ericwu17/SPI_steno_keyboard_kicad/s.kicad_pcb

## KiCad design s.kicad_pcb (2025-11-19)

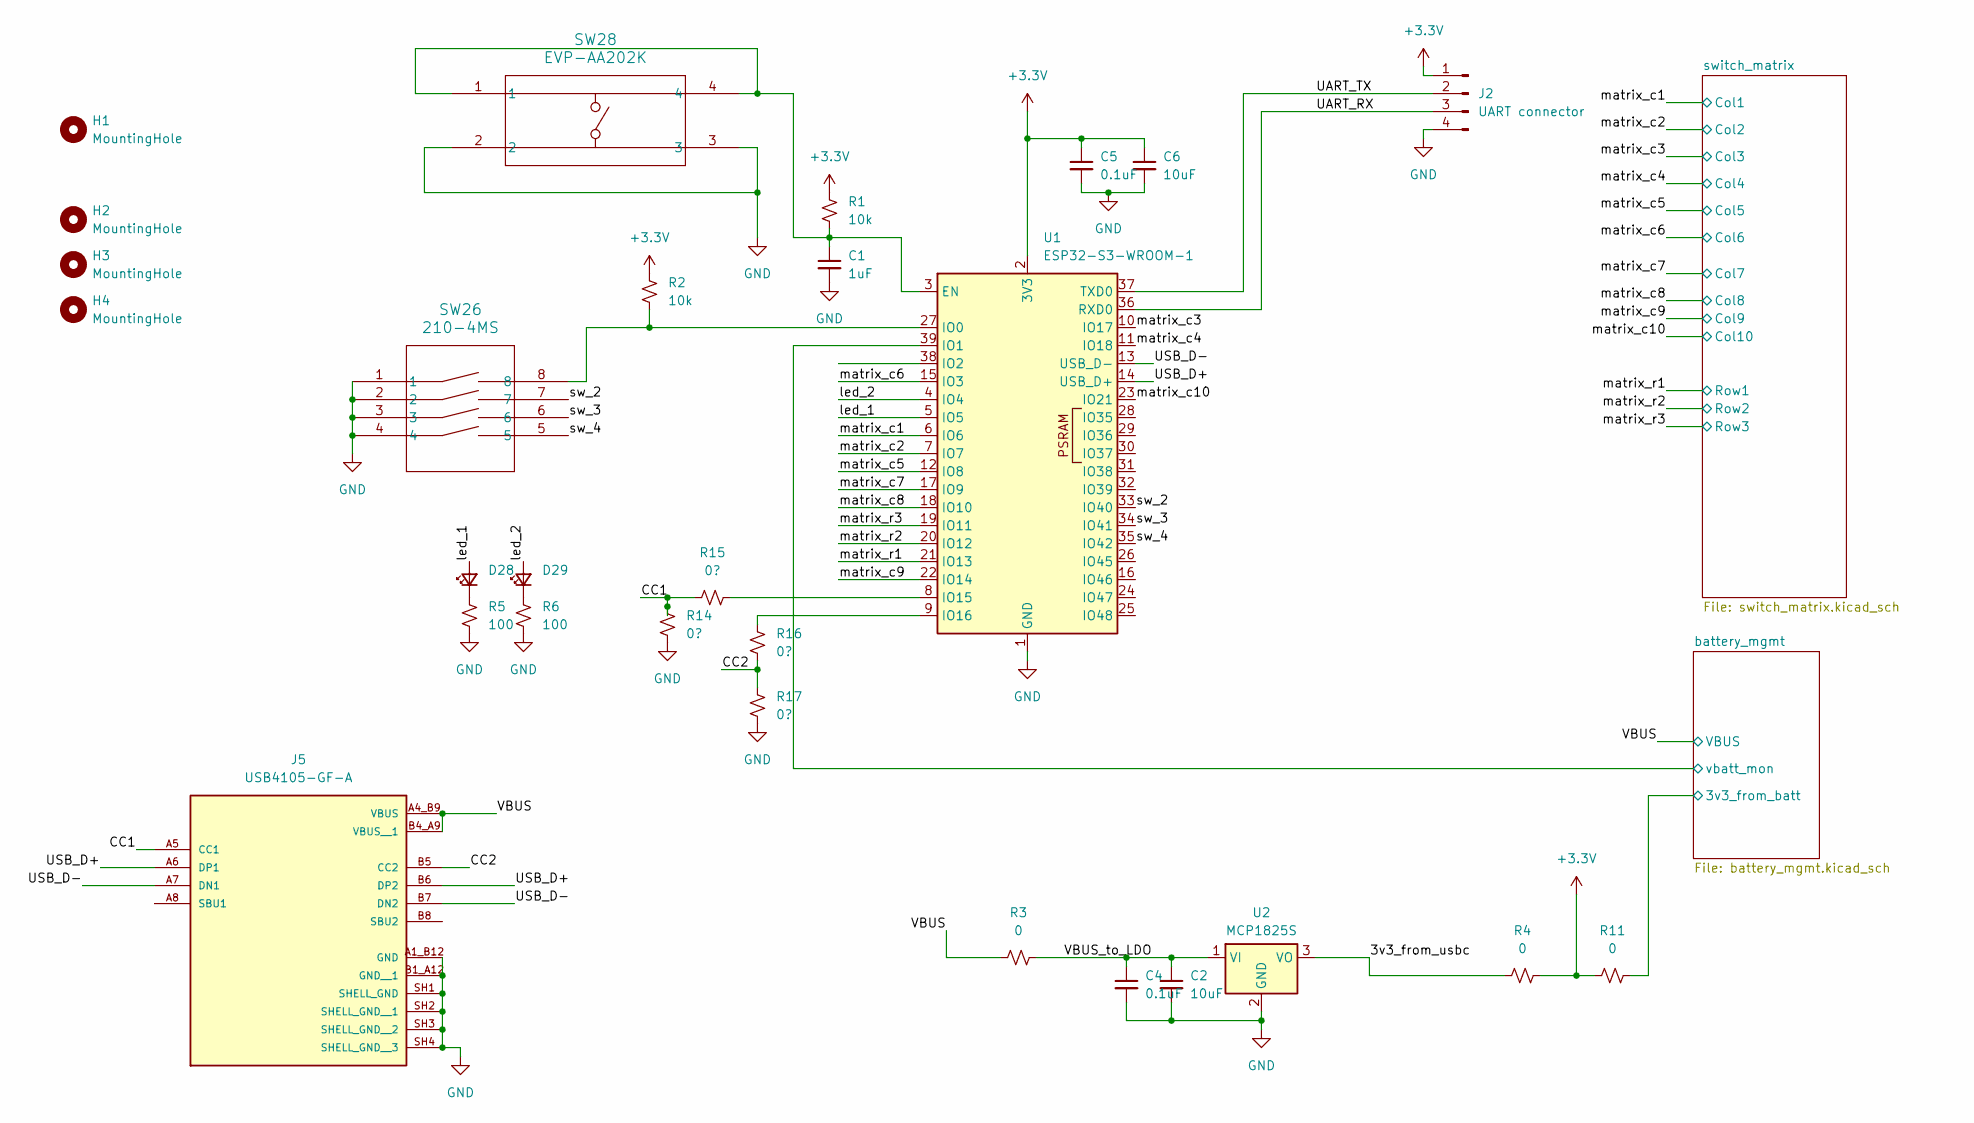
[picture p1: schematic s.kicad_sch]

Parts:
C1: 1uF; C_0805_2012Metric_Pad1.18x1.45mm_HandSolder
C2, C6: 10uF; C_0805_2012Metric_Pad1.18x1.45mm_HandSolder
C4, C5: 0.1uF; C_0805_2012Metric_Pad1.18x1.45mm_HandSolder
D28, D29: LED_0805_2012Metric_Pad1.15x1.40mm_HandSolder
H1, H2, H3, H4: MountingHole; MountingHole_3mm
J2: UART connector; PinHeader_1x04_P2.54mm_Vertical
J5: USB4105-GF-A; GCT_USB4105-GF-A; PARTREV B4
R1, R2: 10k; R_0805_2012Metric_Pad1.20x1.40mm_HandSolder
R3, R4, R11: 0; R_0805_2012Metric_Pad1.20x1.40mm_HandSolder
R5, R6: 100; R_0805_2012Metric_Pad1.20x1.40mm_HandSolder
R14, R15, R16, R17: 0?; R_0805_2012Metric_Pad1.20x1.40mm_HandSolder
SW26: 210-4MS; DIP8_210-4_CTS
SW28: EVP-AA202K; SW_EVP-AA102K_PAN
U1: ESP32-S3-WROOM-1
U2: MCP1825S; SOT-223-3_TabPin2

Connections:
+3.3V: C5.1, C6.1, J2.1, R1.1, R2.1, R4.2, R11.1, U1.2 (3V3)
/3v3_from_usbc: R4.1, U2.3 (VO)
/CC1: J5.A5 (CC1), R14.1, R15.1
/CC2: J5.B5 (CC2), R16.1, R17.1
/UART_RX: J2.3, U1.36 (RXD0)
/UART_TX: J2.2, U1.37 (TXD0)
/USB_D+: J5.A6 (DP1), J5.B6 (DP2), U1.14 (USB_D+)
/USB_D-: J5.A7 (DN1), J5.B7 (DN2), U1.13 (USB_D-)
/VBUS: J5.A4_B9 (VBUS), J5.B4_A9 (VBUS__1), R3.1; also elsewhere on the board
/VBUS_to_LDO: C2.1, C4.1, R3.2, U2.1 (VI)
/battery_mgmt/3v3_from_batt: R11.2; also elsewhere on the board
/battery_mgmt/vbatt_mon: U1.39 (IO1); also elsewhere on the board
/led_1: D28.2 (A), U1.5 (IO5)
/led_2: D29.2 (A), U1.4 (IO4)
/matrix_c1: U1.6 (IO6); also elsewhere on the board
/matrix_c2: U1.7 (IO7); also elsewhere on the board
/matrix_c3: U1.10 (IO17); also elsewhere on the board
/matrix_c4: U1.11 (IO18); also elsewhere on the board
/matrix_c5: U1.12 (IO8); also elsewhere on the board
/matrix_c6: U1.15 (IO3); also elsewhere on the board
/matrix_c7: U1.17 (IO9); also elsewhere on the board
/matrix_c8: U1.18 (IO10); also elsewhere on the board
/matrix_c9: U1.22 (IO14); also elsewhere on the board
/matrix_c10: U1.23 (IO21); also elsewhere on the board
/matrix_r1: U1.21 (IO13); also elsewhere on the board
/matrix_r2: U1.20 (IO12); also elsewhere on the board
/matrix_r3: U1.19 (IO11); also elsewhere on the board
/sw_2: SW26.7, U1.33 (IO40)
/sw_3: SW26.6, U1.34 (IO41)
/sw_4: SW26.5, U1.35 (IO42)
GND: C1.2, C2.2, C4.2, C5.2, C6.2, J2.4, J5.A1_B12 (GND), J5.B1_A12 (GND__1), J5.SH1 (SHELL_GND), J5.SH2 (SHELL_GND__1), J5.SH3 (SHELL_GND__2), J5.SH4 (SHELL_GND__3), R5.2, R6.2, R14.2, R17.2, SW26.1, SW26.2, SW26.3, SW26.4, SW28.2, SW28.3, U1.1 (GND), U1.40 (GND), U1.41 (GND), U2.2 (GND); also elsewhere on the board
unnamed: D28.1 (K), R5.1
unnamed: D29.1 (K), R6.1
unnamed: C1.1, R1.2, SW28.1, SW28.4, U1.3 (EN)
unnamed: R2.2, SW26.8, U1.27 (IO0)
unnamed: R15.2, U1.8 (IO15)
unnamed: R16.2, U1.9 (IO16)

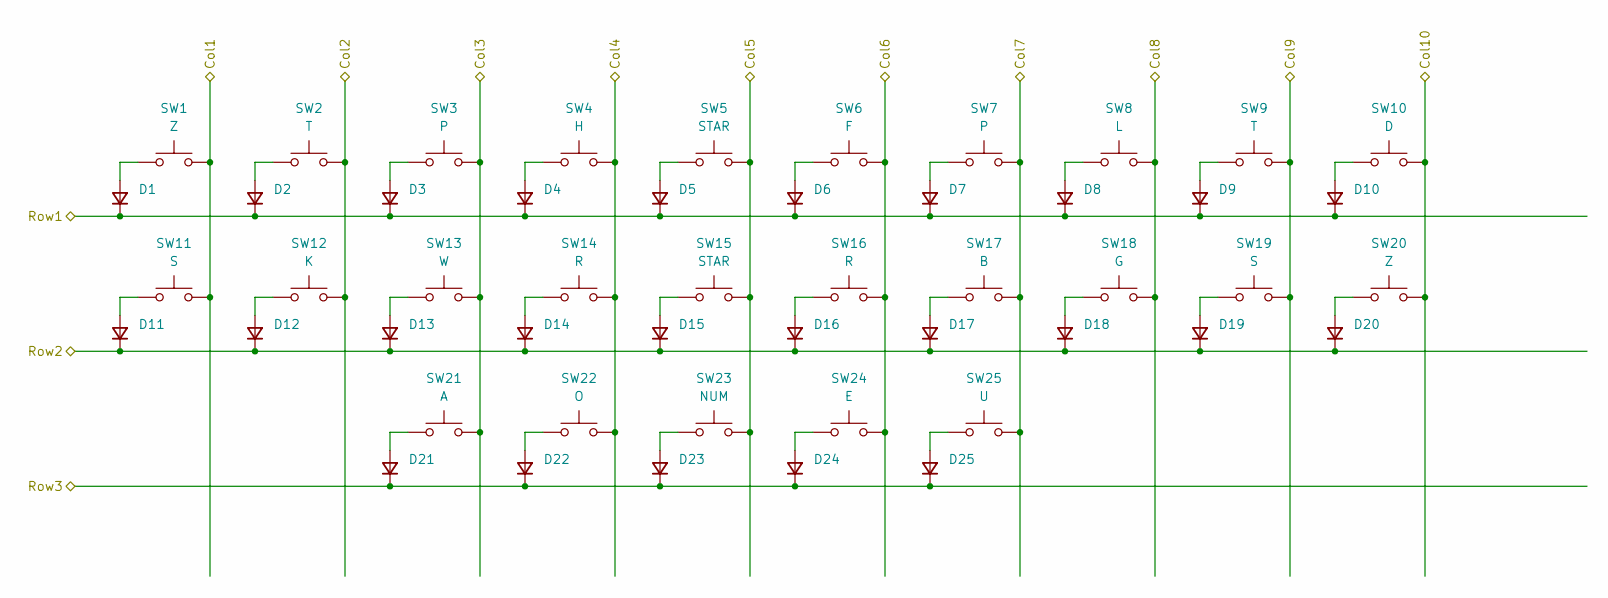
[picture p2: schematic switch_matrix.kicad_sch]

Parts:
D1, D2, D3, D4, D5, D6, D7, D8, D9, D10, D11, D12, D13, D14, D15, D16, D17, D18, D19, D20, D21, D22, D23, D24, D25: D_SOD-323_HandSoldering
SW1, SW20: Z; SW_Kailh_Choc_V1_THT
SW2, SW9: T; SW_Kailh_Choc_V1_THT
SW3, SW7: P; SW_Kailh_Choc_V1_THT
SW4: H; SW_Kailh_Choc_V1_THT
SW5, SW15: STAR; SW_Kailh_Choc_V1_THT
SW6: F; SW_Kailh_Choc_V1_THT
SW8: L; SW_Kailh_Choc_V1_THT
SW10: D; SW_Kailh_Choc_V1_THT
SW11, SW19: S; SW_Kailh_Choc_V1_THT
SW12: K; SW_Kailh_Choc_V1_THT
SW13: W; SW_Kailh_Choc_V1_THT
SW14, SW16: R; SW_Kailh_Choc_V1_THT
SW17: B; SW_Kailh_Choc_V1_THT
SW18: G; SW_Kailh_Choc_V1_THT
SW21: A; SW_Kailh_Choc_V1_THT
SW22: O; SW_Kailh_Choc_V1_THT
SW23: NUM; SW_Kailh_Choc_V1_THT
SW24: E; SW_Kailh_Choc_V1_THT
SW25: U; SW_Kailh_Choc_V1_THT

Connections:
/matrix_c1: SW1.2, SW11.2; also elsewhere on the board
/matrix_c2: SW2.2, SW12.2; also elsewhere on the board
/matrix_c3: SW3.2, SW13.2, SW21.2; also elsewhere on the board
/matrix_c4: SW4.2, SW14.2, SW22.2; also elsewhere on the board
/matrix_c5: SW5.2, SW15.2, SW23.2; also elsewhere on the board
/matrix_c6: SW6.2, SW16.2, SW24.2; also elsewhere on the board
/matrix_c7: SW7.2, SW17.2, SW25.2; also elsewhere on the board
/matrix_c8: SW8.2, SW18.2; also elsewhere on the board
/matrix_c9: SW9.2, SW19.2; also elsewhere on the board
/matrix_c10: SW10.2, SW20.2; also elsewhere on the board
/matrix_r1: D1.1 (K), D2.1 (K), D3.1 (K), D4.1 (K), D5.1 (K), D6.1 (K), D7.1 (K), D8.1 (K), D9.1 (K), D10.1 (K); also elsewhere on the board
/matrix_r2: D11.1 (K), D12.1 (K), D13.1 (K), D14.1 (K), D15.1 (K), D16.1 (K), D17.1 (K), D18.1 (K), D19.1 (K), D20.1 (K); also elsewhere on the board
/matrix_r3: D21.1 (K), D22.1 (K), D23.1 (K), D24.1 (K), D25.1 (K); also elsewhere on the board
unnamed: D1.2 (A), SW1.1
unnamed: D2.2 (A), SW2.1
unnamed: D3.2 (A), SW3.1
unnamed: D4.2 (A), SW4.1
unnamed: D5.2 (A), SW5.1
unnamed: D6.2 (A), SW6.1
unnamed: D7.2 (A), SW7.1
unnamed: D8.2 (A), SW8.1
unnamed: D9.2 (A), SW9.1
unnamed: D10.2 (A), SW10.1
unnamed: D11.2 (A), SW11.1
unnamed: D12.2 (A), SW12.1
unnamed: D13.2 (A), SW13.1
unnamed: D14.2 (A), SW14.1
unnamed: D15.2 (A), SW15.1
unnamed: D16.2 (A), SW16.1
unnamed: D17.2 (A), SW17.1
unnamed: D18.2 (A), SW18.1
unnamed: D19.2 (A), SW19.1
unnamed: D20.2 (A), SW20.1
unnamed: D21.2 (A), SW21.1
unnamed: D22.2 (A), SW22.1
unnamed: D23.2 (A), SW23.1
unnamed: D24.2 (A), SW24.1
unnamed: D25.2 (A), SW25.1

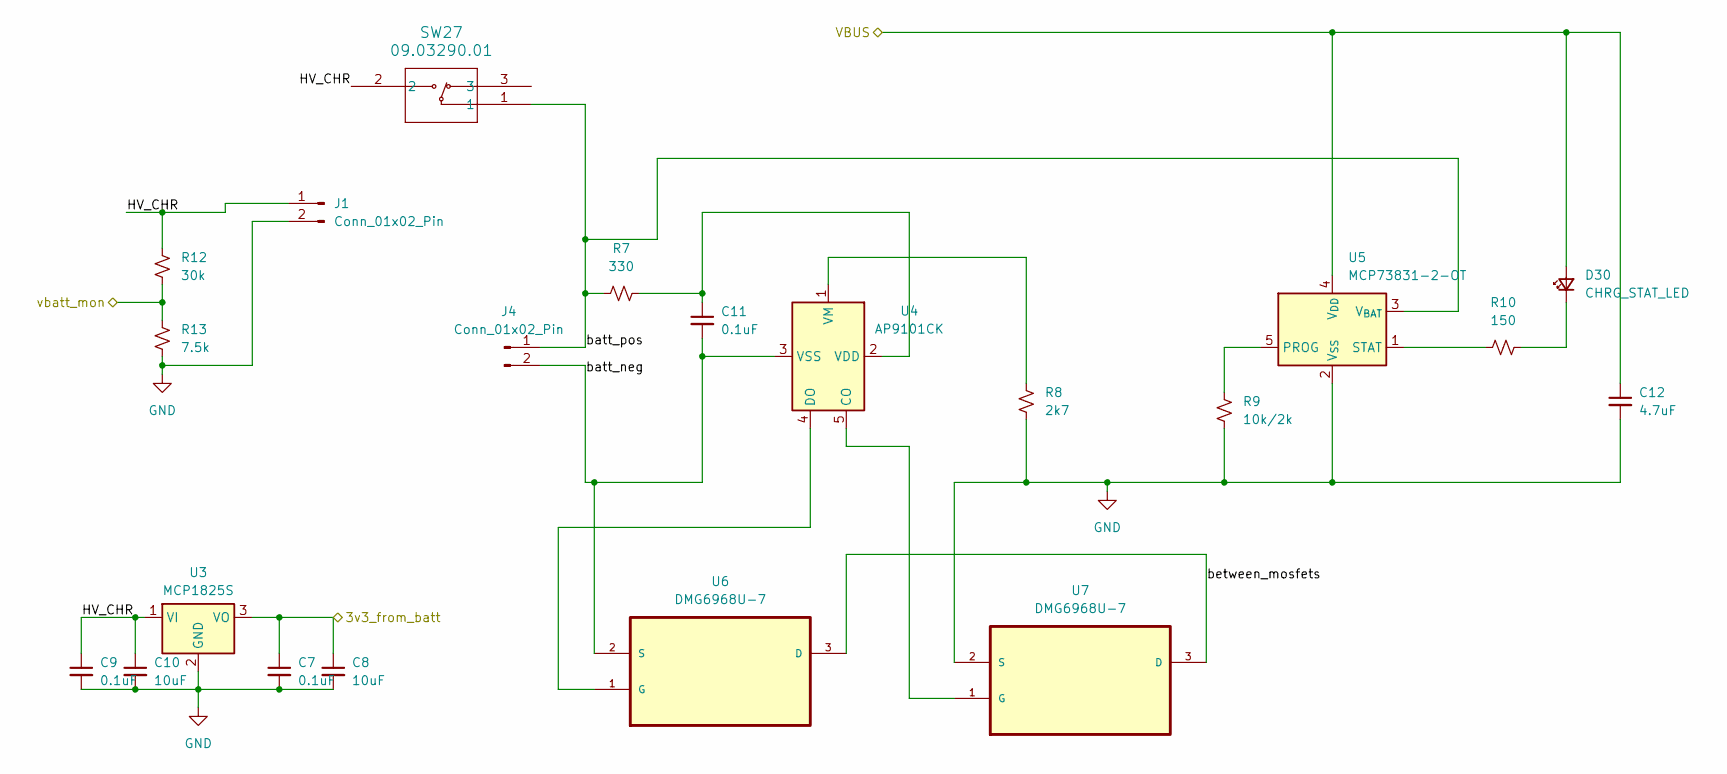
[picture p3: schematic battery_mgmt.kicad_sch]

Parts:
C7, C9, C11: 0.1uF; C_0805_2012Metric_Pad1.18x1.45mm_HandSolder
C8, C10: 10uF; C_0805_2012Metric_Pad1.18x1.45mm_HandSolder
C12: 4.7uF; C_0805_2012Metric_Pad1.18x1.45mm_HandSolder
D30: CHRG_STAT_LED; LED_0805_2012Metric_Pad1.15x1.40mm_HandSolder
J1: Conn_01x02_Pin; PinHeader_1x02_P2.54mm_Vertical
J4: Conn_01x02_Pin; JST_PH_S2B-PH-K_1x02_P2.00mm_Horizontal
R7: 330; R_0805_2012Metric_Pad1.20x1.40mm_HandSolder
R8: 2k7; R_0805_2012Metric_Pad1.20x1.40mm_HandSolder
R9: 10k/2k; R_0805_2012Metric_Pad1.20x1.40mm_HandSolder
R10: 150; R_0805_2012Metric_Pad1.20x1.40mm_HandSolder
R12: 30k; R_0805_2012Metric_Pad1.20x1.40mm_HandSolder
R13: 7.5k; R_0805_2012Metric_Pad1.20x1.40mm_HandSolder
SW27: 09.03290.01; 09.03290_EAO
U3: MCP1825S; SOT-223-3_TabPin2
U4: AP9101CK; SOT-23-5
U5: MCP73831-2-OT; SOT-23-5
U6, U7: DMG6968U-7; SOT95P240X110-3N; MPN DMG6968U-7

Connections:
/VBUS: C12.1, D30.2 (A), U5.4 (V_{DD}); also elsewhere on the board
/battery_mgmt/3v3_from_batt: C7.1, C8.1, U3.3 (VO); also elsewhere on the board
/battery_mgmt/HV_CHR: C9.1, C10.1, J1.1, R12.1, SW27.2, U3.1 (VI)
/battery_mgmt/batt_neg: C11.2, J4.2, U4.3 (VSS), U6.2 (S)
/battery_mgmt/batt_pos: J4.1, R7.1, SW27.1, U5.3 (V_{BAT})
/battery_mgmt/between_mosfets: U6.3 (D), U7.3 (D)
/battery_mgmt/vbatt_mon: R12.2, R13.1; also elsewhere on the board
GND: C7.2, C8.2, C9.2, C10.2, C12.2, J1.2, R8.2, R9.2, R13.2, U3.2 (GND), U5.2 (V_{SS}), U7.2 (S); also elsewhere on the board
unnamed: D30.1 (K), R10.2
unnamed: U4.5 (CO), U7.1 (G)
unnamed: U4.4 (DO), U6.1 (G)
unnamed: C11.1, R7.2, U4.2 (VDD)
unnamed: R8.1, U4.1 (VM)
unnamed: R9.1, U5.5 (PROG)
unnamed: R10.1, U5.1 (STAT)

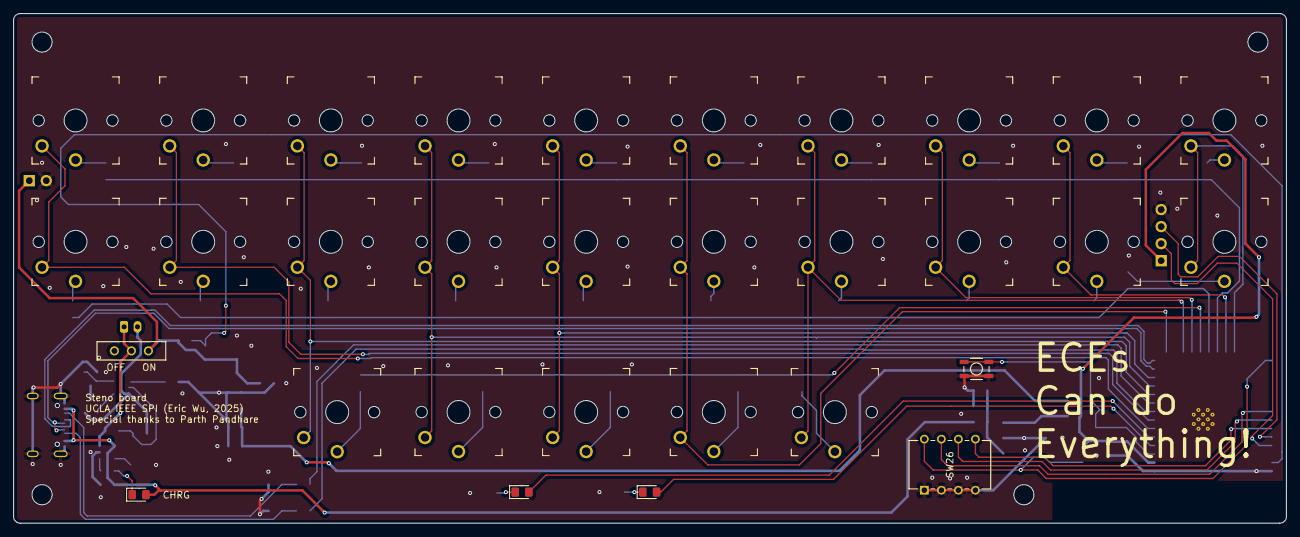
[picture p4: board s.kicad_pcb from above]

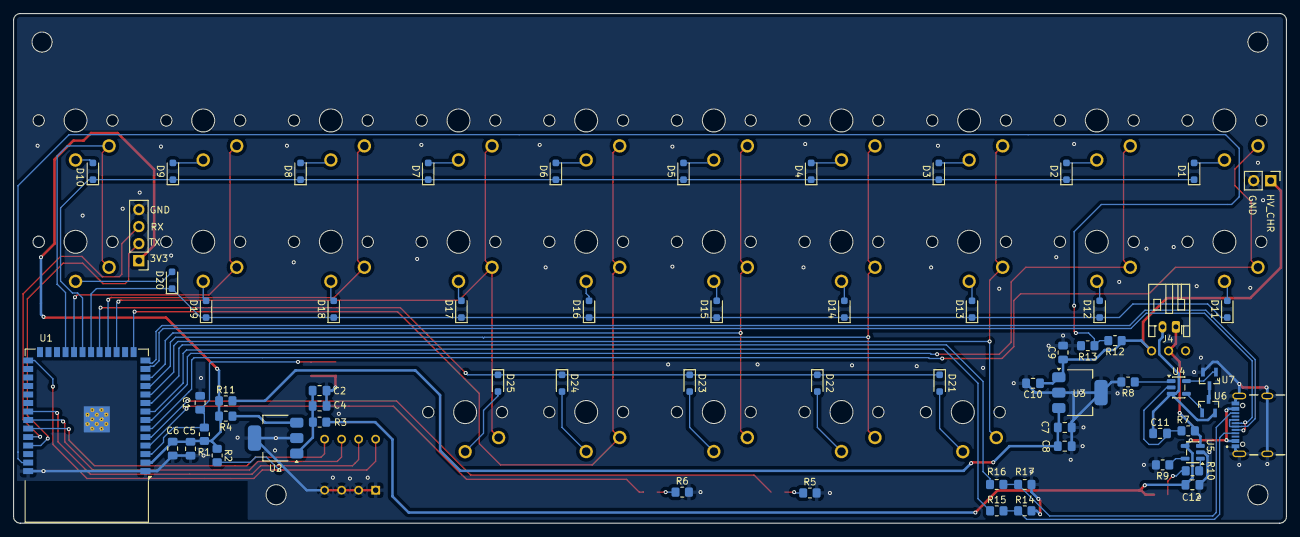
[picture p5: board s.kicad_pcb from below]

Board: 2 copper layers, 190.0 x 76.0 mm, 99 parts (64 on the bottom side), 73 nets.
