ericwu17/SPI_steno_keyboard_kicad/(commit log)

2025-10-25 initial commit 2: initialize project
    [s.kicad_pcb, s.kicad_sch]
2025-10-25 got basic MCU powering from USBC
    [s.kicad_pcb, s.kicad_sch, switch_matrix.kicad_sch]
2025-10-25 make key matrix
    [s.kicad_sch, switch_matrix.kicad_sch]
2025-10-25 rename backup, for somme reason
    idk why kicad did this
2025-10-25 connect MCU to matrix
    [s.kicad_sch, switch_matrix.kicad_sch]
2025-10-26 add supporting stuff and assigned footprints
    [s.kicad_pcb, s.kicad_sch, switch_matrix.kicad_sch]
2025-10-26 copied battery charging schematic
    [battery_mgmt.kicad_sch, s.kicad_sch]
2025-10-26 update footprints
    [battery_mgmt.kicad_sch, s.kicad_pcb]
2025-10-26 move stuff around on pcb
    [s.kicad_pcb]
2025-10-26 routed the key matrix
    [s.kicad_pcb, s.kicad_sch]
2025-10-26 quick commit: moved stuff around and deleted a capacitor
    [s.kicad_pcb, s.kicad_sch]
2025-10-26 route some more stuff
    [s.kicad_pcb, s.kicad_sch]
2025-10-26 route dip switches
    [s.kicad_pcb]
2025-10-26 route battery charging stuff
    [battery_mgmt.kicad_sch, s.kicad_pcb]
2025-10-26 move stuff around (minor)
    [s.kicad_pcb]
2025-10-27 add submodule for Kailh Choc V1 footprints
2025-10-27 change key footprints to kailh choc (PCB not fixed yet)
    [s.kicad_pcb, switch_matrix.kicad_sch]
2025-10-27 remove 2 of the 4 user LEDs
    [s.kicad_pcb, s.kicad_sch]
2025-10-27 PCB cleanup remove old row/col traces
    [s.kicad_pcb]
2025-10-28 route PCB with new keys and new key spacing
    key spacing done by hand
    [s.kicad_pcb]
2025-10-30 modify schematic: add switch between voltage regs
    [battery_mgmt.kicad_sch, s.kicad_sch]
2025-10-30 work on PCB
    [s.kicad_pcb]
2025-10-30 more work on PCB: routed grounds
    [s.kicad_pcb, s.kicad_sch]
2025-10-30 fix DRC violations and warnings
    [s.kicad_pcb]
2025-11-01 use 0-ohm resistors, not switches, to control power source
    [s.kicad_pcb, s.kicad_sch]
2025-11-01 add a voltage divider for battery voltage monitoring
    [battery_mgmt.kicad_sch, s.kicad_pcb, s.kicad_sch]
2025-11-06 make gap in PCB for antenna
    [s.kicad_pcb]
2025-11-06 remove silkscreen from MCU component
    [s.kicad_pcb]
2025-11-06 change min hole size to 0.2 mm
    [s.kicad_pcb]
2025-11-06 some silk screen changes
    [s.kicad_pcb]
2025-11-06 silk screen changes
    [s.kicad_pcb]
2025-11-06 new usb port footprint
    [s.kicad_pcb, s.kicad_sch]
2025-11-07 change power switch
    [battery_mgmt.kicad_sch, s.kicad_pcb]
2025-11-07 minor edit to some traces
    [s.kicad_pcb]
2025-11-07 add design rules from https://github.com/labtroll/KiCad-DesignRules
2025-11-07 update silk screen to confrom to design rules
    [s.kicad_pcb]
2025-11-07 reroute board
    [s.kicad_pcb, s.kicad_sch]
2025-11-07 add planes for ground
    [s.kicad_pcb]
2025-11-07 add 3 of 4 mounting holes
    still need to think about the last one...
    [s.kicad_pcb, s.kicad_sch]
2025-11-08 add the fourth mounting hole
    [s.kicad_pcb, s.kicad_sch]
2025-11-08 add a few vias
    [s.kicad_pcb]
2025-11-13 add a push button for RST
    [s.kicad_pcb, s.kicad_sch]
2025-11-16 change footprint of JST connector. Vertical -> horizontal
    [battery_mgmt.kicad_sch, s.kicad_pcb, s.kicad_sch]
2025-11-18 rename labels for mounting holes
    [s.kicad_sch]
2025-11-18 WIP: drafting PCB edges
    [s.kicad_pcb]
2025-11-18 WIP :finalize edge cuts
    The new board dimensions are 189.95mm x 76.05mm
    with corners of radius 1.00 mm
    [s.kicad_pcb]
2025-11-18 WIP: routing traces
    [s.kicad_pcb]
2025-11-18 WIP: more routing done
    [s.kicad_pcb]
2025-11-18 WIP: route everything except ground planes
    [s.kicad_pcb]
2025-11-18 add fill zones for GND
    [s.kicad_pcb]
2025-11-18 add some vias
    [s.kicad_pcb]
2025-11-18 refill all zones
    [s.kicad_pcb]
2025-11-18 update footprints from libraries
    [s.kicad_pcb]
2025-11-18 move silkscreen (was intersecting with vias)
    [s.kicad_pcb]
2025-11-19 add a test point for battery voltage
    [battery_mgmt.kicad_sch, s.kicad_pcb]
